SEGAINVEX-ELECTRONICA/Fuente-de-2KV-para-haz-de-electrones/readme.md

## [UNIVERSIDAD AUTÓNOMA DE MADRID](https://www.uam.es/UAM/Home.htm?language=es)
## [SEGAINVEX-Electrónica](https://www.uam.es/uam/segainvex)
**Proyecto OT:20161033**

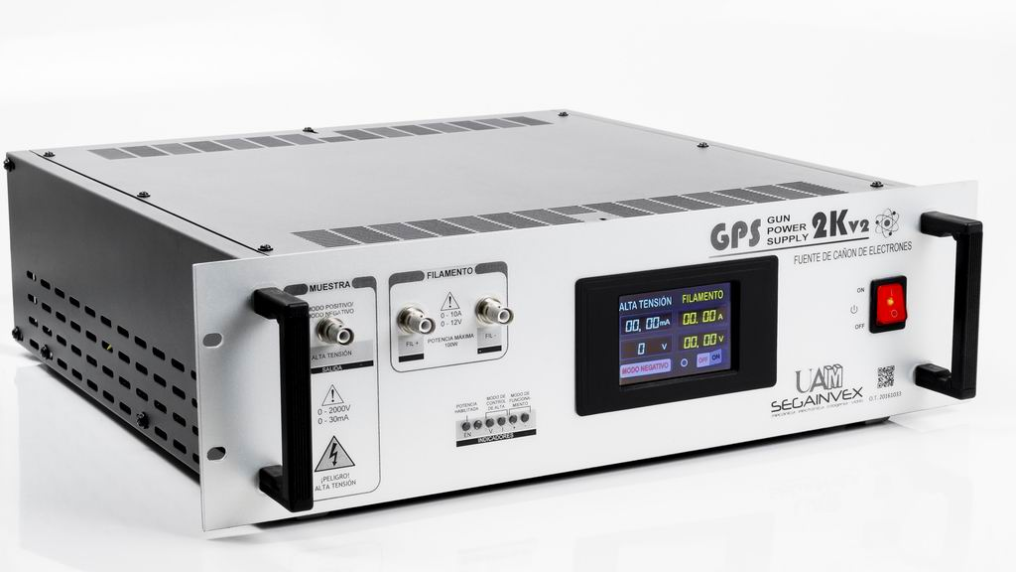
[picture p1: fotos/foto1.jpg]
frontal


## DESCRIPCIÓN
### Fuente de alimenación de +-2KV HV u 12V, 30mA en filamento para cañón de haz de electrones
### Controlable mediante pantalla táctil y/o software de PC por puerto USB o Bluetooth. La fuente se puede configura para dos modos de funcionamiento; haz de electrones o haz de iones. También se desarrolla el software de control para PC con LAbWindows/CVI.
 
### Desarrollado por SEGAINVEX-Electrónica para el [Departamento de Física de la Materia Condensada de la UAM](https://www.fmc.uam.es/research/nano-spm-lab/)
### Diciembre 2019

## [SOFTWARE DE PC](https://github.com/SEGAINVEX-ELECTRONICA/Fuente-de-2KV-para-haz-de-electrones/blob/main/software/)
### Desarrollado con [LabWindowsCVI de NI](https://www.ni.com/es-es.html)

## [FIRMWARE Arduino DUE](https://github.com/SEGAINVEX-ELECTRONICA/Fuente-de-2KV-para-haz-de-electrones/blob/main/firmware/)
### Desarrollado con [Atmel Studio 6](https://www.microchip.com/en-us/development-tools-tools-and-software/avr-and-sam-downloads-archive)
    
## [ESQUEMAS](https://github.com/SEGAINVEX-ELECTRONICA/Fuente-de-2KV-para-haz-de-electrones/blob/main/esquemas/)

## [PROYECTO HARDWARE](https://github.com/SEGAINVEX-ELECTRONICA/Fuente-de-2KV-para-haz-de-electrones/blob/main/proyecto/)
### 
## [FOTOS DEL EQUIPO](https://github.com/SEGAINVEX-ELECTRONICA/Fuente-de-2KV-para-haz-de-electrones/blob/main/fotos/) 
###
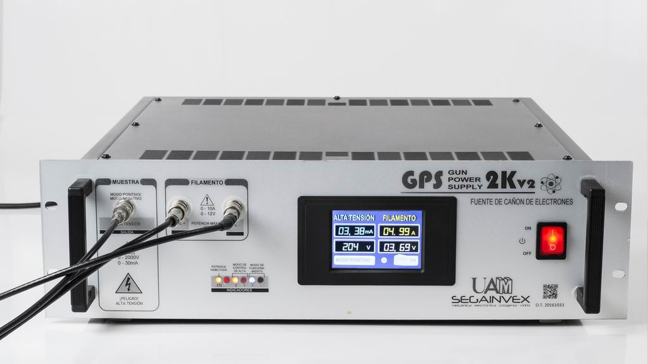
[picture p2: fotos/foto2.jpg]
Frontal

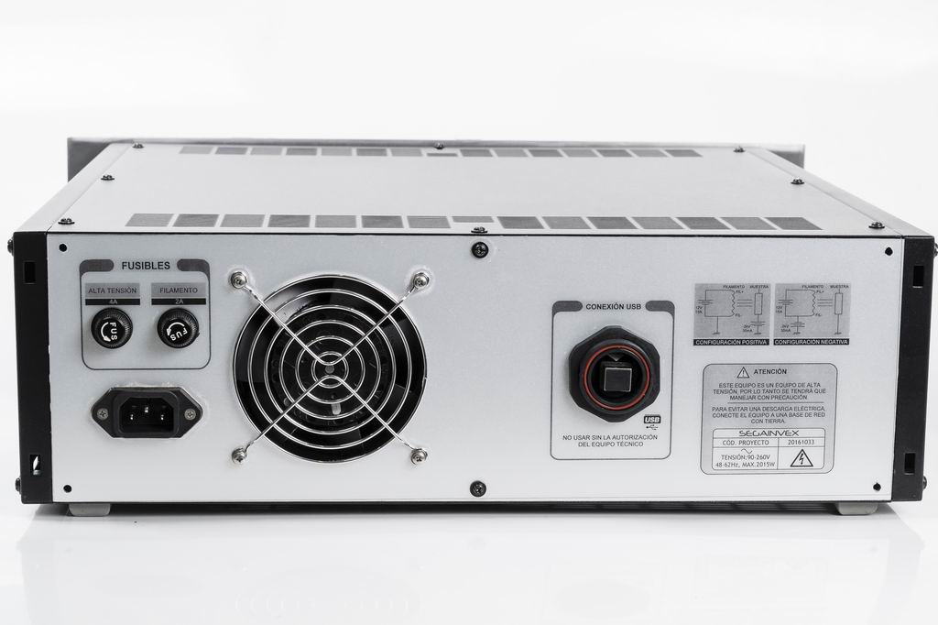
[picture p3: fotos/foto3.jpg]
Trasera

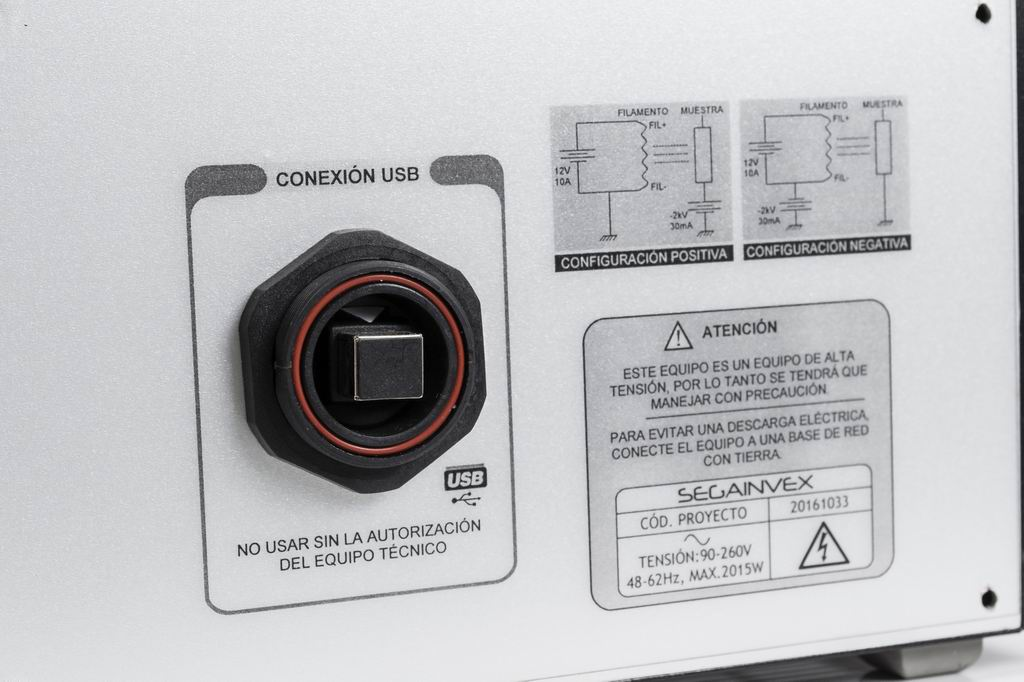
[picture p4: fotos/foto5.jpg]
Puerto USB

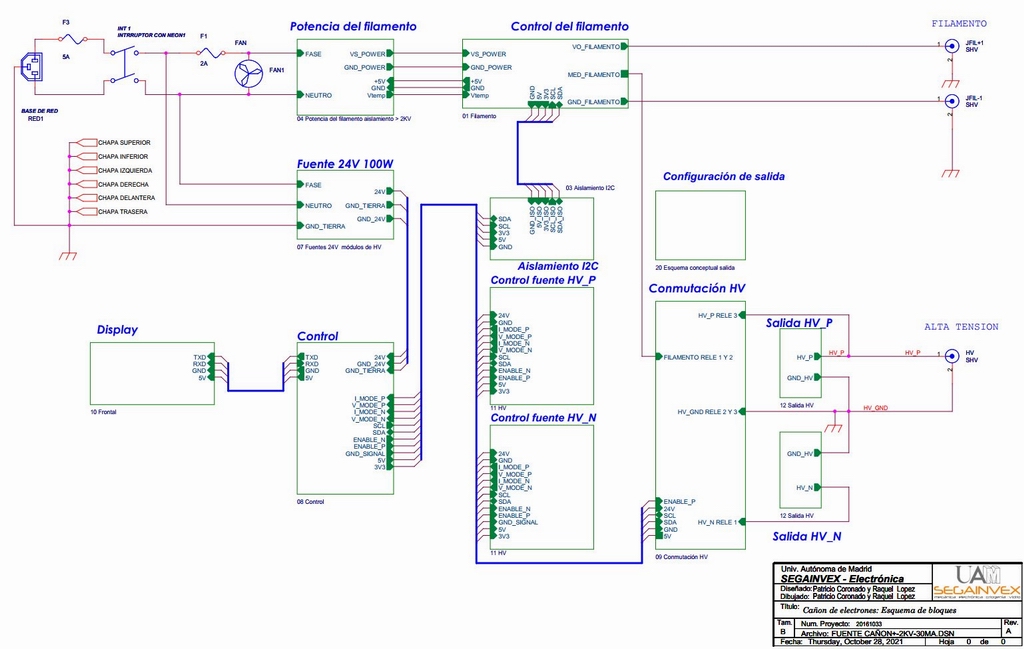
[picture p5: fotos/esquema.JPG]
Esquema de bloques

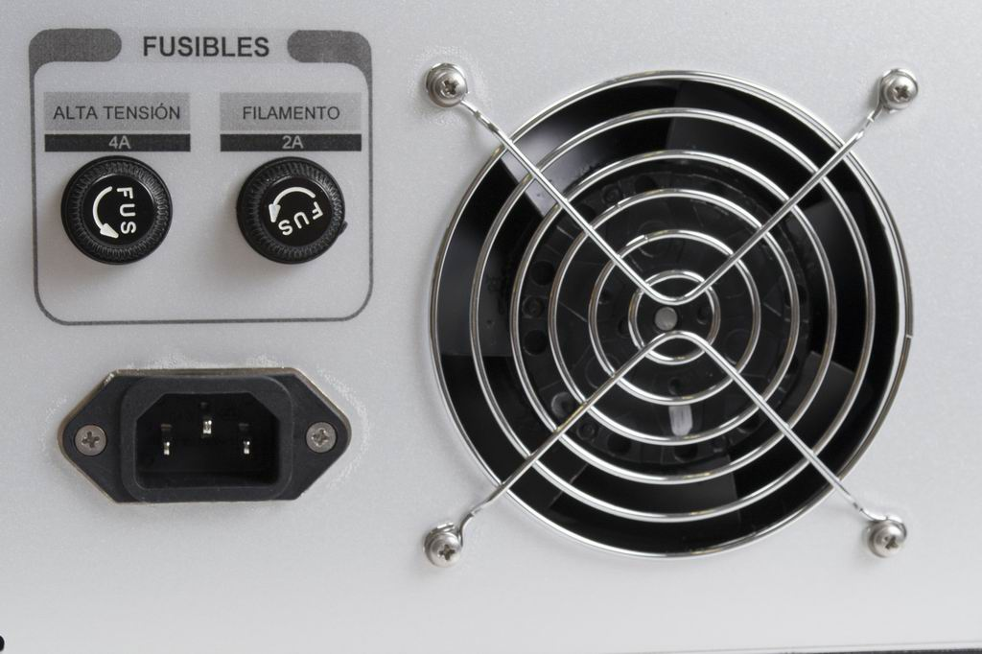
[picture p6: fotos/foto6.jpg]
Fusibles y ventilador

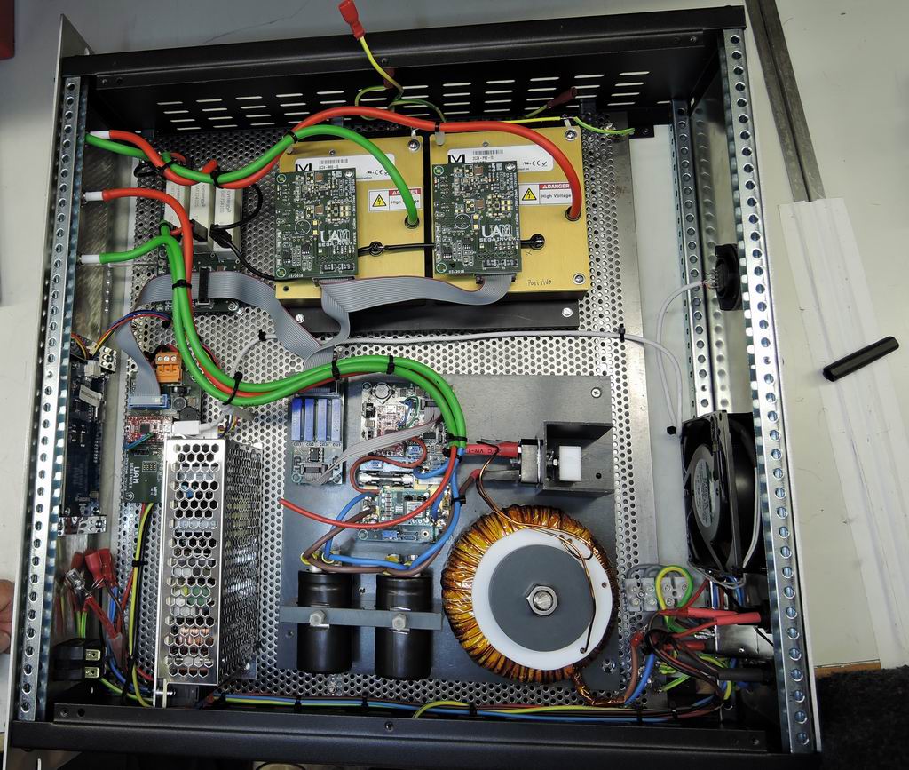
[picture p7: fotos/foto7.jpg]
Electrónica del sistema

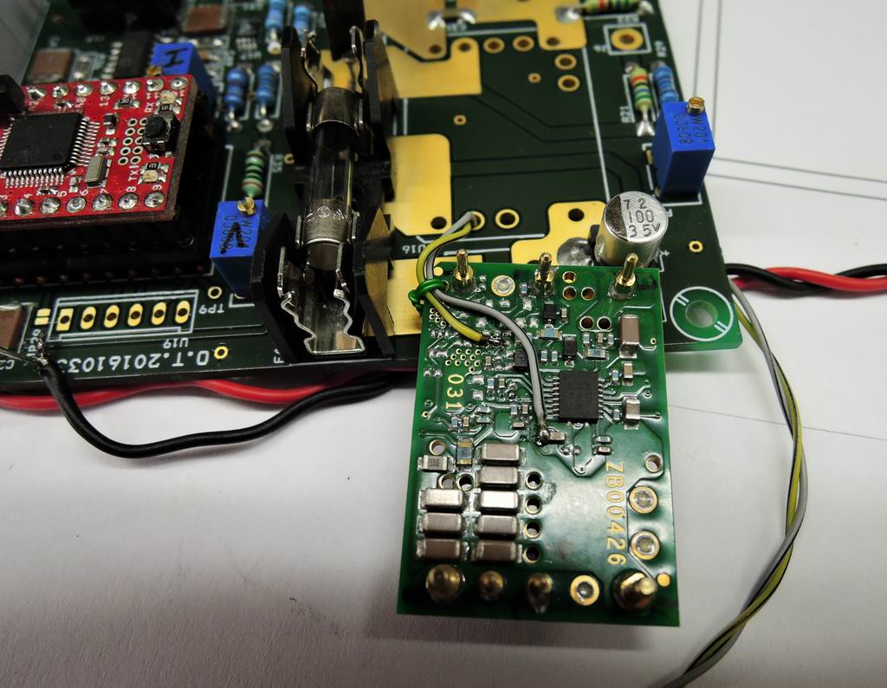
[picture p8: fotos/foto8.jpg]
Detalle del módulo de potencia del filamento

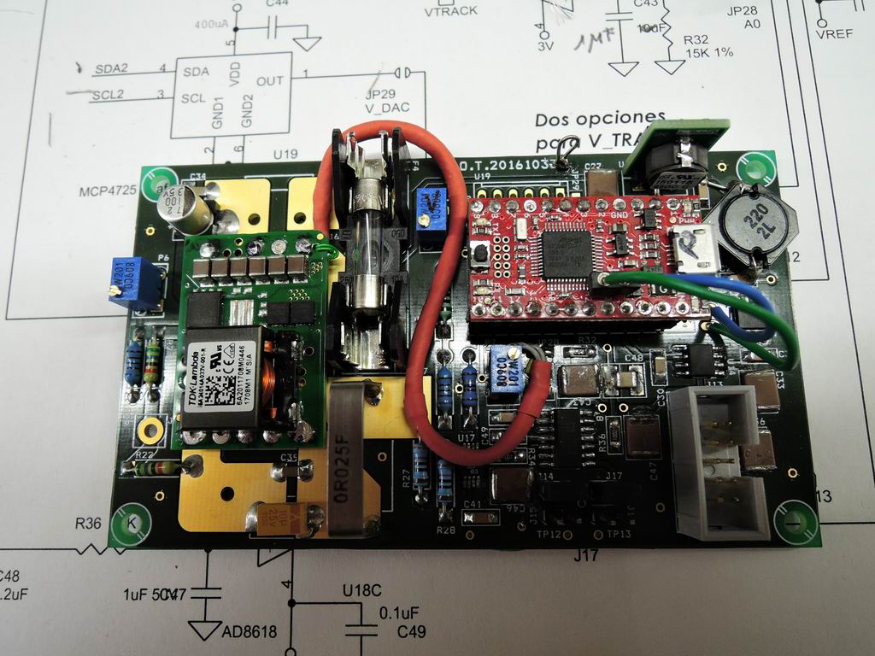
[picture p9: fotos/foto9.jpg]

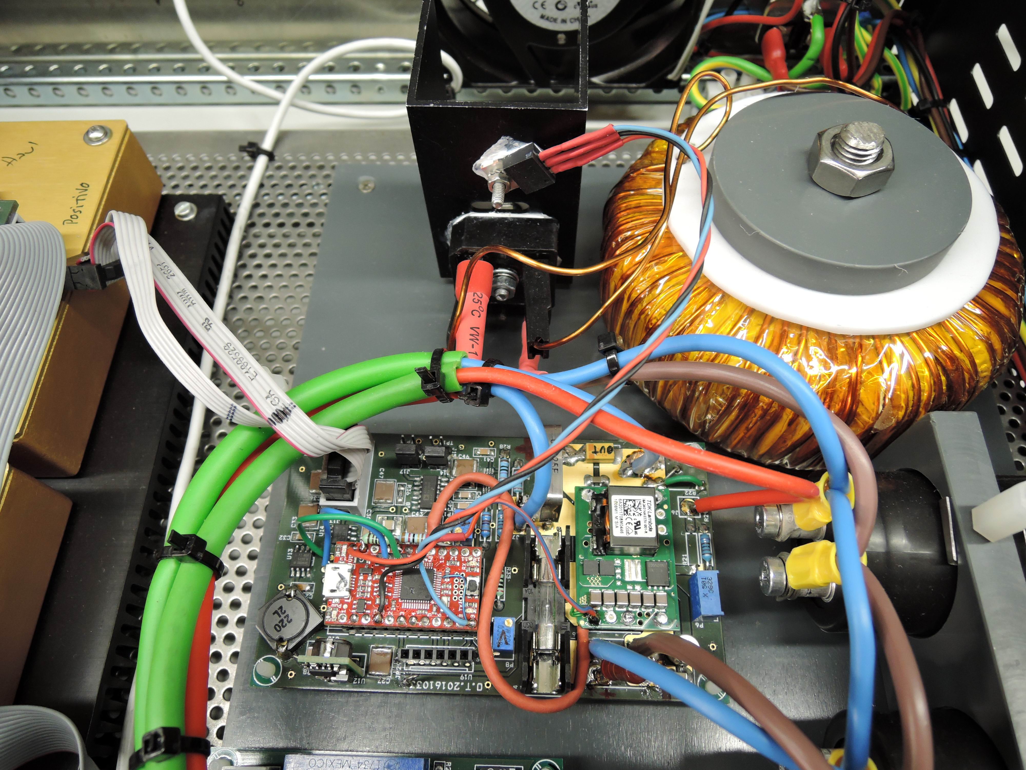
[picture p10: fotos/foto10.jpg]

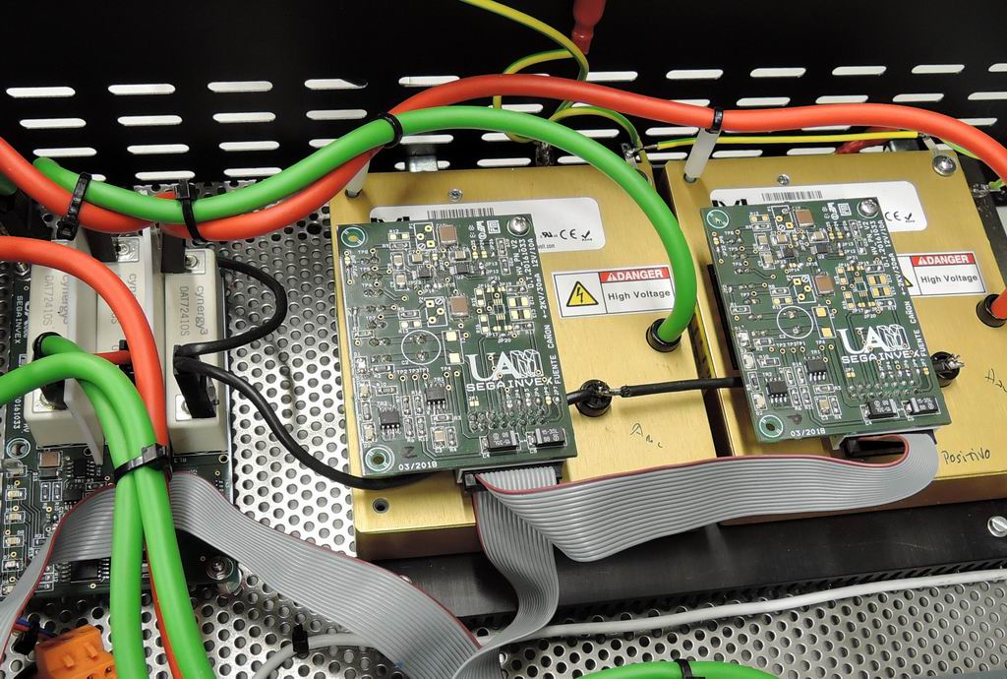
[picture p11: fotos/foto11.jpg]
Fuentes de HV y control

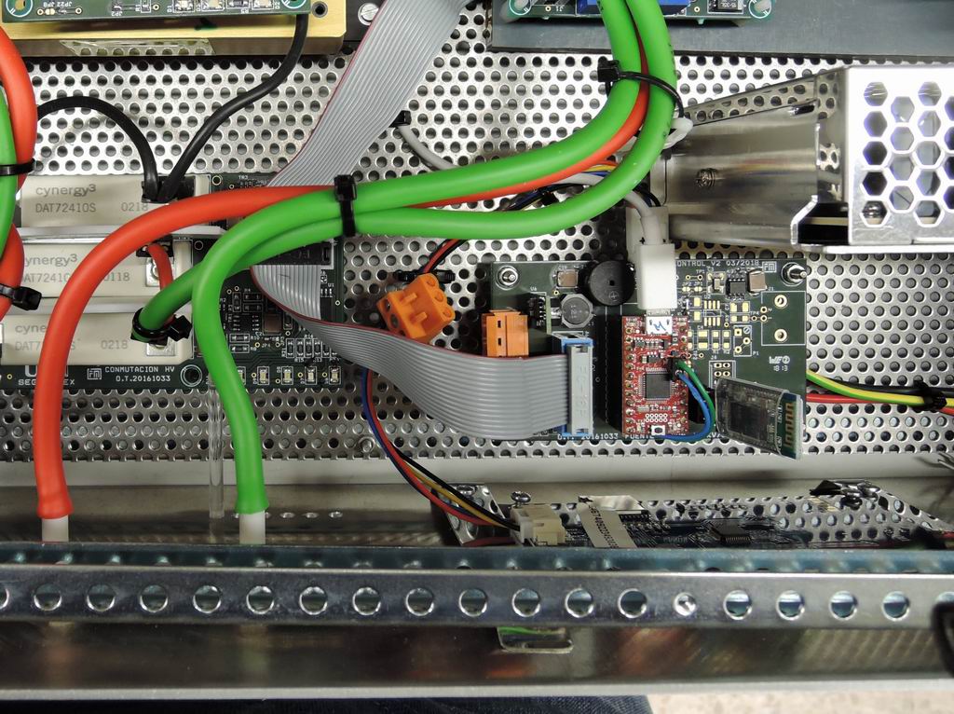
[picture p12: fotos/foto12.jpg]
Control de todo el sistema

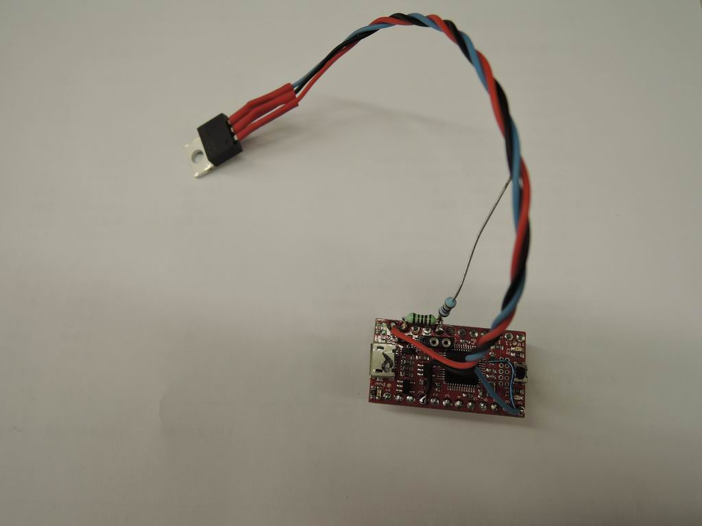
[picture p13: fotos/foto13.jpg]
microcontrolador del filamento y sensor de temperatura del puente rectificador


###### publicado desde "X:\Proyecto\2016\20161033 D Fuente cañon ±2KV-30mA, 12V-10A\[11] GITHUB"
