SEGAINVEX-ELECTRONICA/Fuente-de-2KV-para-haz-de-electrones/fotos/foto4.jpg

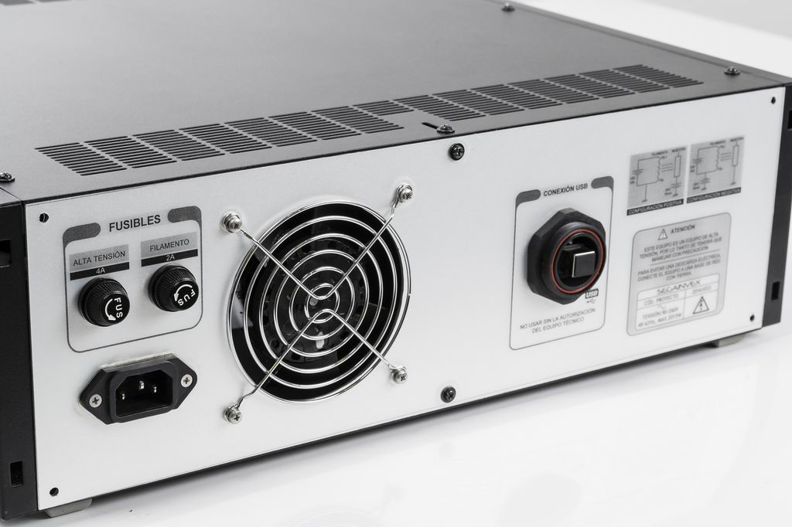
fotos/foto4.jpg
