SEGAINVEX-ELECTRONICA/Fuente-de-2KV-para-haz-de-electrones/esquemas/esquema_conceptual.pdf

# -FIL FPOL TIERRA

# -FIL FPOL TIERRA

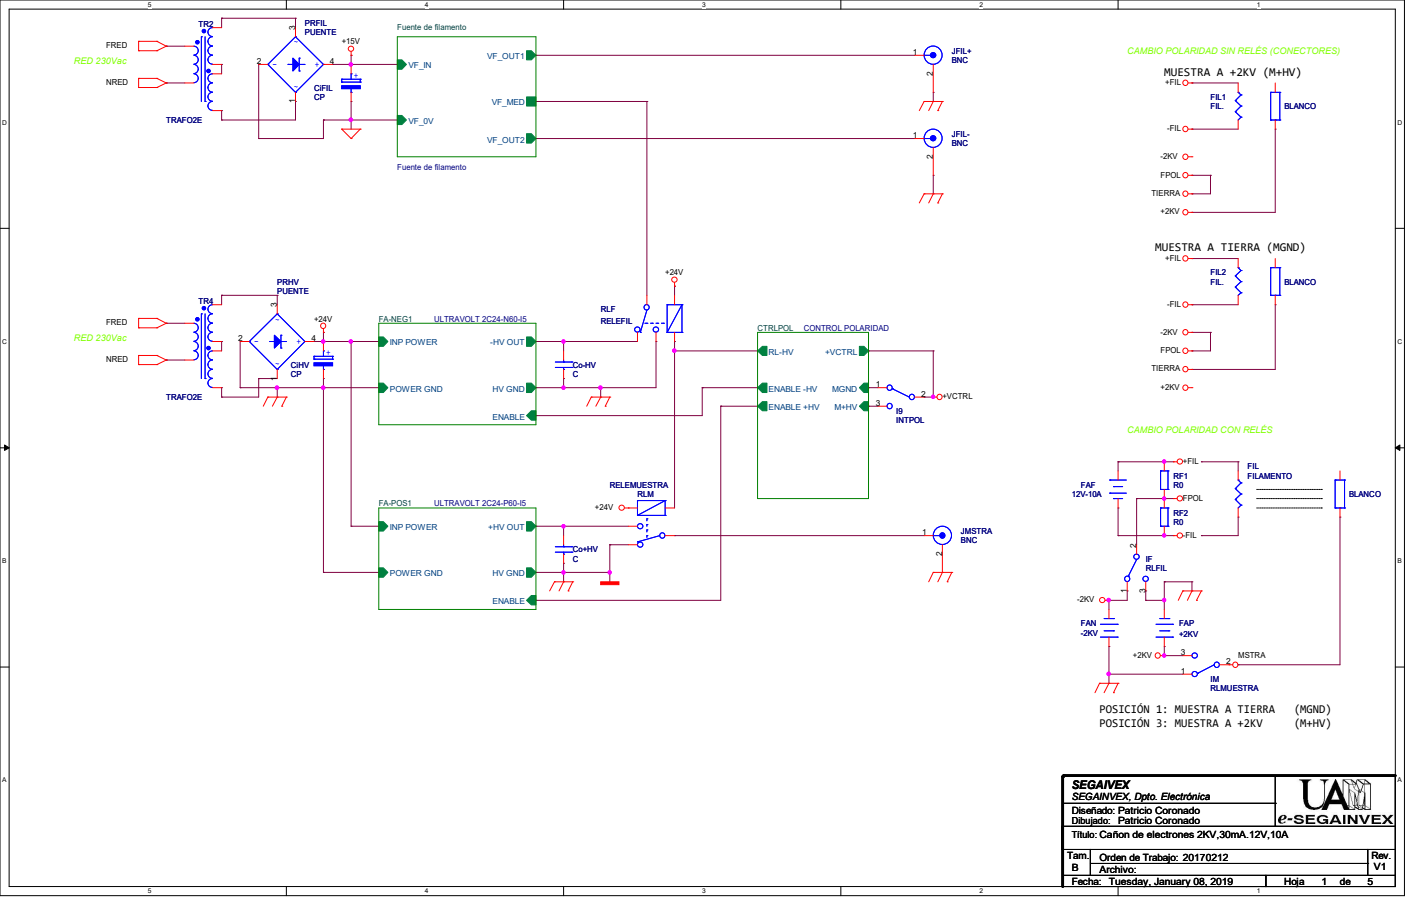
[picture p15: page 1]
FRED; NRED; +VCTRL; +FIL FPOL; MSTRA; -FIL Título:; Tam. Orden de Trabajo:; Rev.; Fecha:; Hoja; Diseñado: Dibujado:; SEGAINVEX, Dpto. Electrónica Archivo:; V1 Cañon de electrones 2KV,30mA.12V,10A; SEGAIVEX; Patricio Coronado B; Tuesday, January 08, 2019; 5 Patricio Coronado Título:; 5 Patricio Coronado; RED 230Vac; CAMBIO POLARIDAD CON RELÉS POSICIÓN 1: MUESTRA A TIERRA; (MGND); POSICIÓN 3: MUESTRA A +2KV; VF_OUT1 VF_OUT2 VF_MED; FIL1 FIL. FA-NEG1; ULTRAVOLT 2C24-N60-I5; -HV OUT POWER GND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

Fuente de filamento Fuente de filamento VF_IN

CAMBIO POLARIDAD SIN RELÉS (CONECTORES)
MUESTRA A +2KV (M+HV)
+FIL

2 CTRLPOL CONTROL POLARIDAD M+HV

MUESTRA A TIERRA (MGND)

FIL2 FIL. + CiHV CP
~PRHV
PUENTE
