SEGAINVEX-ELECTRONICA/Fuente-de-2KV-para-haz-de-electrones/esquemas/esquema_conceptual_filamento.pdf

# Salida al bus IC

# - Vsense(out) +

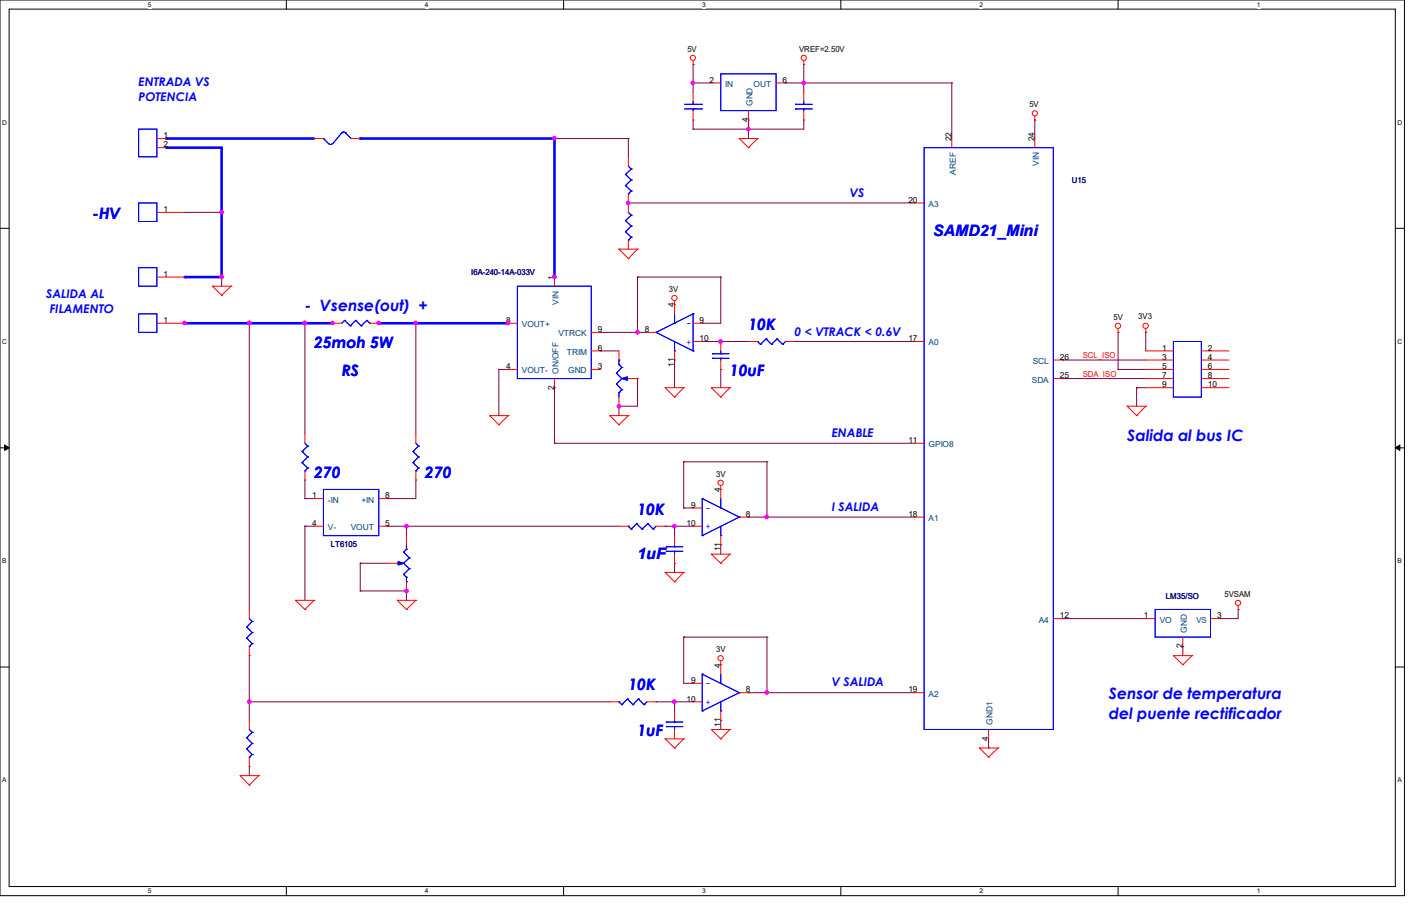
[picture p16: page 1]
SCL_ISO; SDA_ISO; VREF=2.50V; 5VSAM; SALIDA AL FILAMENTO; ENTRADA VS POTENCIA; I SALIDA; V SALIDA; 0 < VTRACK < 0.6V; ENABLE; GND; VIN; 1 ON/OFF; 4 OUT 6 U15 SAMD21_Mini GND¹; 4 GPIO8 11 A4 12; AREF 22; VIN ²⁴ SDA 25 SCL 26; VOUT; 25moh 5W

2 GND 3 VOUT- 4 TRIM 6 VOUT+ 8 VTRCK 9

Sensor de temperatura
del puente rectificador
