SEGAINVEX-ELECTRONICA/Fuente-de-2KV-para-haz-de-electrones/esquemas/0_esquema_de_bloques.pdf

## FILAMENTO

# Configuración de salida

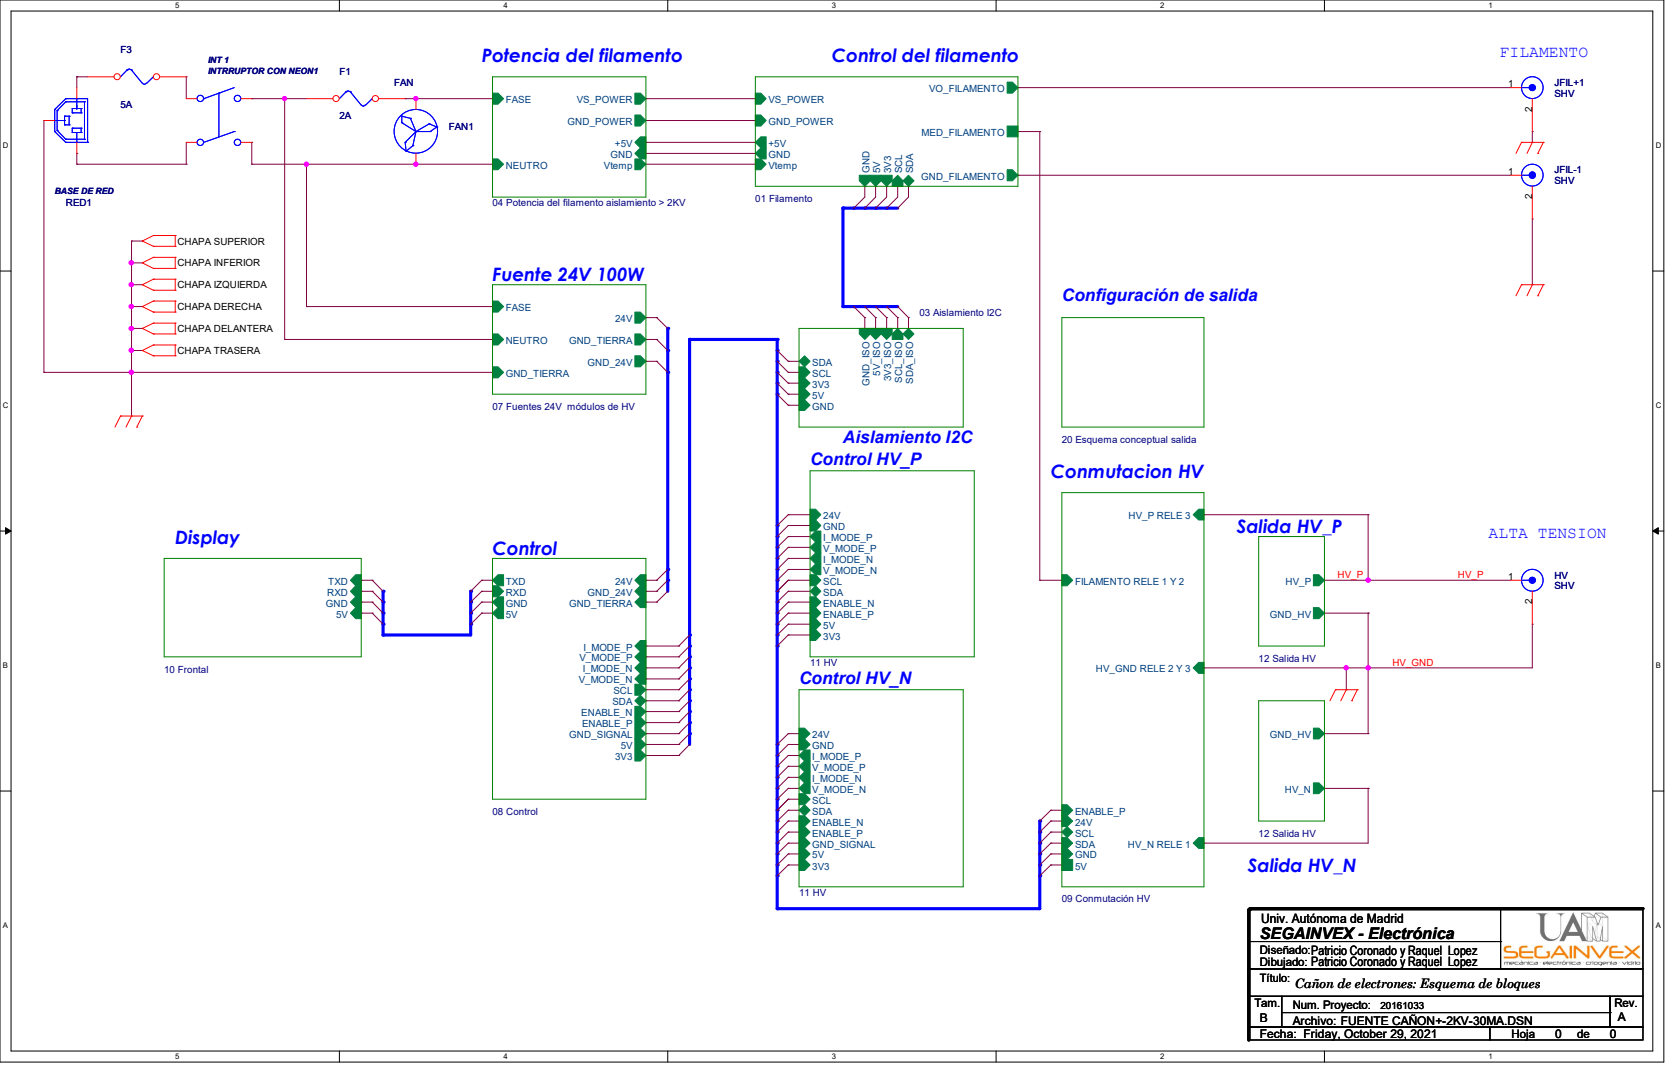
[picture p17: page 1]
HV_GND; CHAPA SUPERIOR; CHAPA INFERIOR; Título: Tam. Num. Proyecto:; Rev.; Fecha:; Hoja; de Diseñado: Dibujado: Archivo: SEGAINVEX - Electrónica; Friday, October 29, 2021; 0 FUENTE CAÑON+-2KV-30MA.DSN; 20161033 Título: Tam. Num. Proyecto:; ALTA TENSION; 24V GND_24V; FASE NEUTRO; GND_TIERRA; Control del filamento 01 Filamento; VO_FILAMENTO; GND_FILAMENTO; VS_POWER; GND_POWER; GND 5V3V³ SCL SDA; MED_FILAMENTO; +5V GND; Vtemp; INT 1; Display 10 Frontal; TXD; RXD GND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

F3 | INTRRUPTOR CON NEON1 F1

Potencia del filamento 04 Potencia del filamento aislamiento > 2KV

BASE DE RED
RED1

Fuente 24V 100W 07 Fuentes 24V módulos de HV

CHAPA IZQUIERDA CHAPA DERECHA CHAPA DELANTERA CHAPA TRASERA

20 Esquema conceptual salida
Conmutacion HV

Salida HV_P 12 Salida HV HV_P

Salida HV_N ¹² Salida HV HV_N

09 Conmutación HV HV_N RELE 1

Univ. Autónoma de Madrid
Patricio Coronado y Raquel Lopez B

Cañon de electrones: Esquema de bloques
