SEGAINVEX-ELECTRONICA/Fuente-de-2KV-para-haz-de-electrones/esquemas/conmutacion_hv.pdf

## TAMAÑO PLACA 120 X 70

P7 | P6

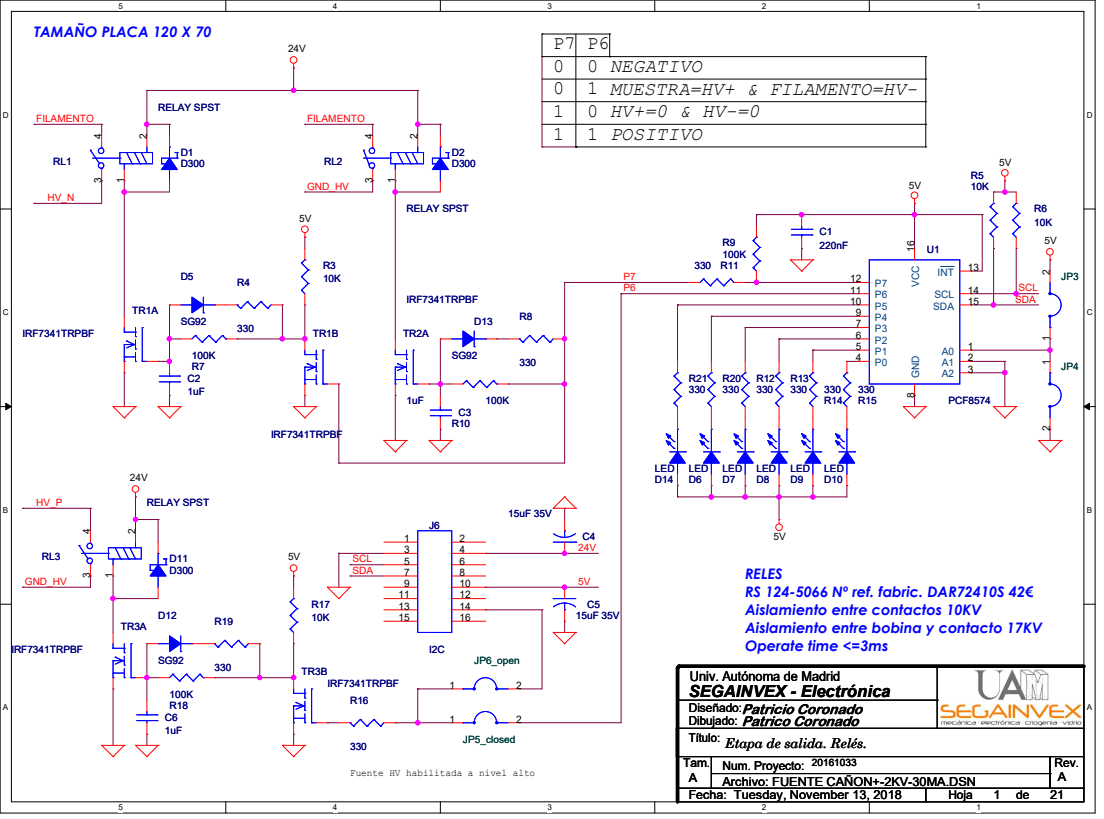
[picture p18: page 1]

0 | 0 NEGATIVO
0 | 1 MUESTRA=HV+ & FILAMENTO=HV-

RELES
RS 124-5066 Nº ref. fabric. DAR72410S 42€
Aislamiento entre contactos 10KV
Aislamiento entre bobina y contacto 17KV
Operate time <=3ms

Univ. Autónoma de Madrid
SEGAINVEX - Electrónica
Diseñado:
Dibujado:
Título:
Etapa de salida. Relés.

Fuente HV habilitada a nivel alto
