SEGAINVEX-ELECTRONICA/Fuente-de-2KV-para-haz-de-electrones/esquemas/control.pdf

## After power-up, the I/O pins are tri-stated

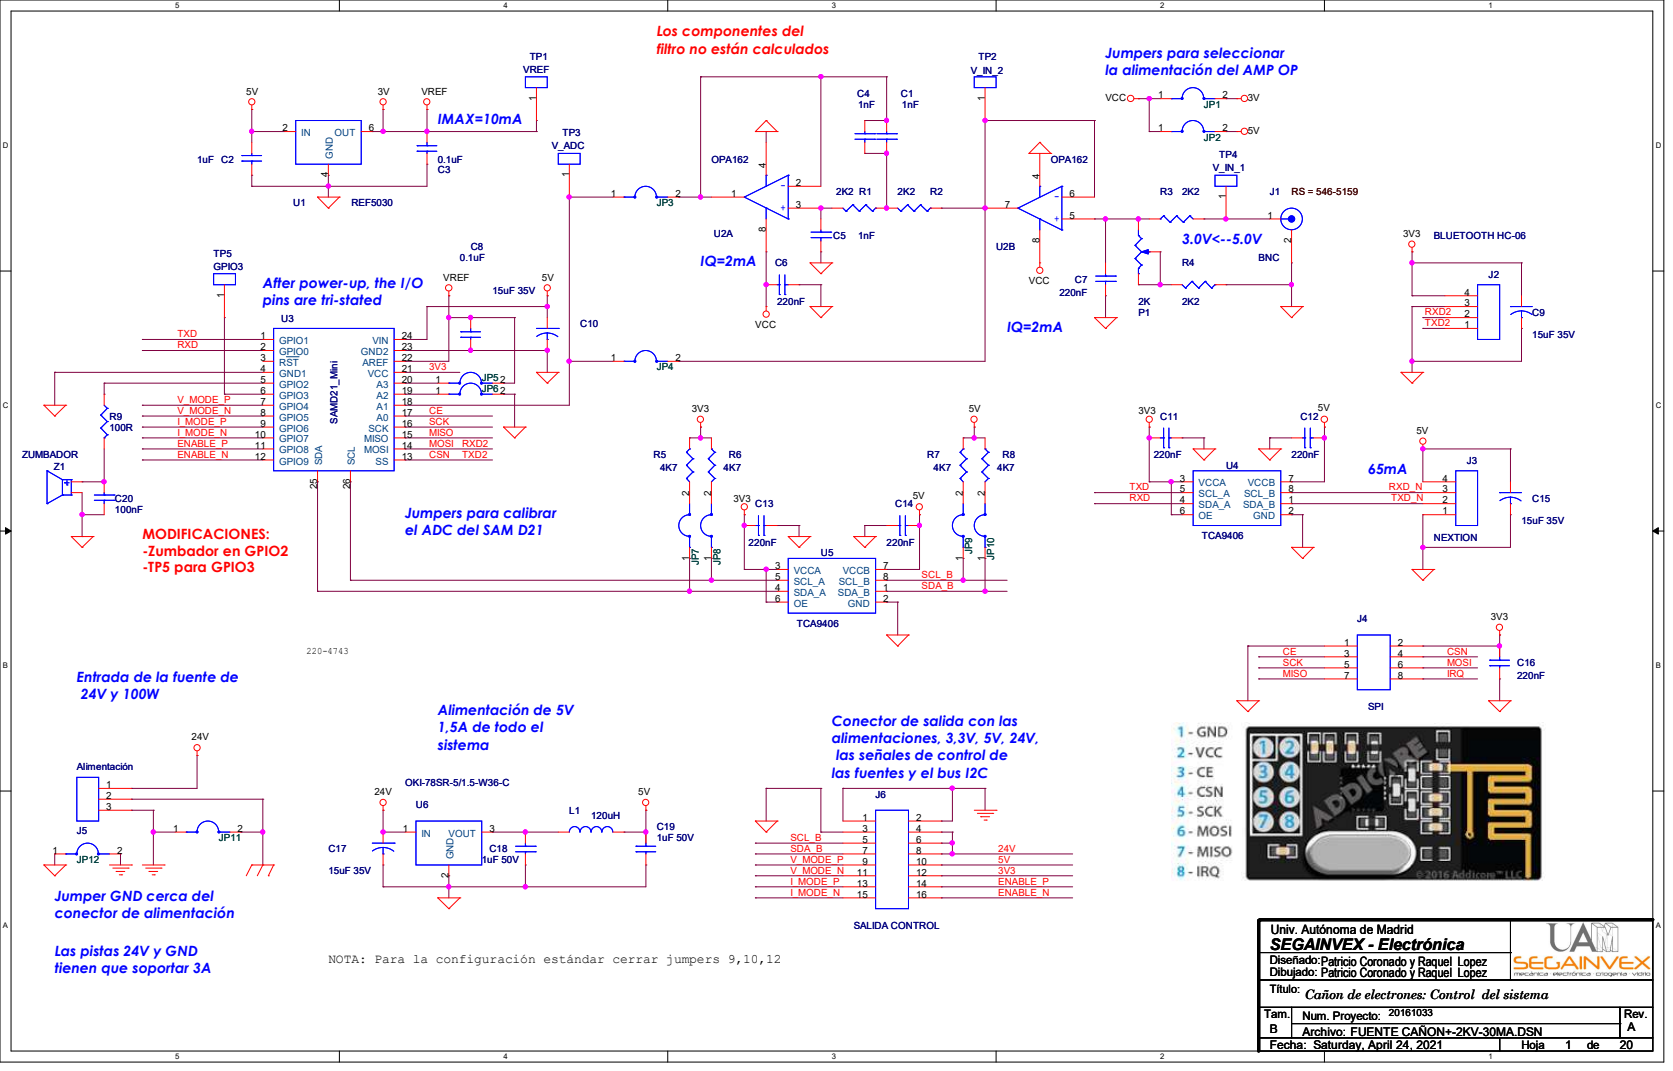
[picture p19: page 1]

Los componentes del
filtro no están calculados

Jumpers para seleccionar
la alimentación del AMP OP

1 U3 SAMD21_Mini GPIO1 1 GPIO0 2 RST 3 GND1 4 GPIO6 9 GPIO7 10 GPIO8 11 GPIO9 12 SS 13 MOSI 14 MISO 15 SCK 16 A0 17 A1 18 A2 19 A3 20 VCC 21 AREF 22 GND2 23 VIN 24 GPIO2 5 GPIO3 6 GPIO4 7 GPIO5 8 SDA 25 SCL 26

Jumpers para calibrar
el ADC del SAM D21

Entrada de la fuente de

Conector de salida con las
alimentaciones, 3,3V, 5V, 24V,
las señales de control de
las fuentes y el bus I2C

Jumper GND cerca del
conector de alimentación

Univ. Autónoma de Madrid
Patricio Coronado y Raquel Lopez B

NOTA: Para la configuración estándar cerrar jumpers 9,10,12

Cañon de electrones: Control del sistema
