SEGAINVEX-ELECTRONICA/Fuente-de-2KV-para-haz-de-electrones/esquemas/control_del_filamento.pdf

| U12 OKI-78SR-5/1.5-W36-C ENTRADA VS=18V a 24V J12

# ON/OFF VTRACK

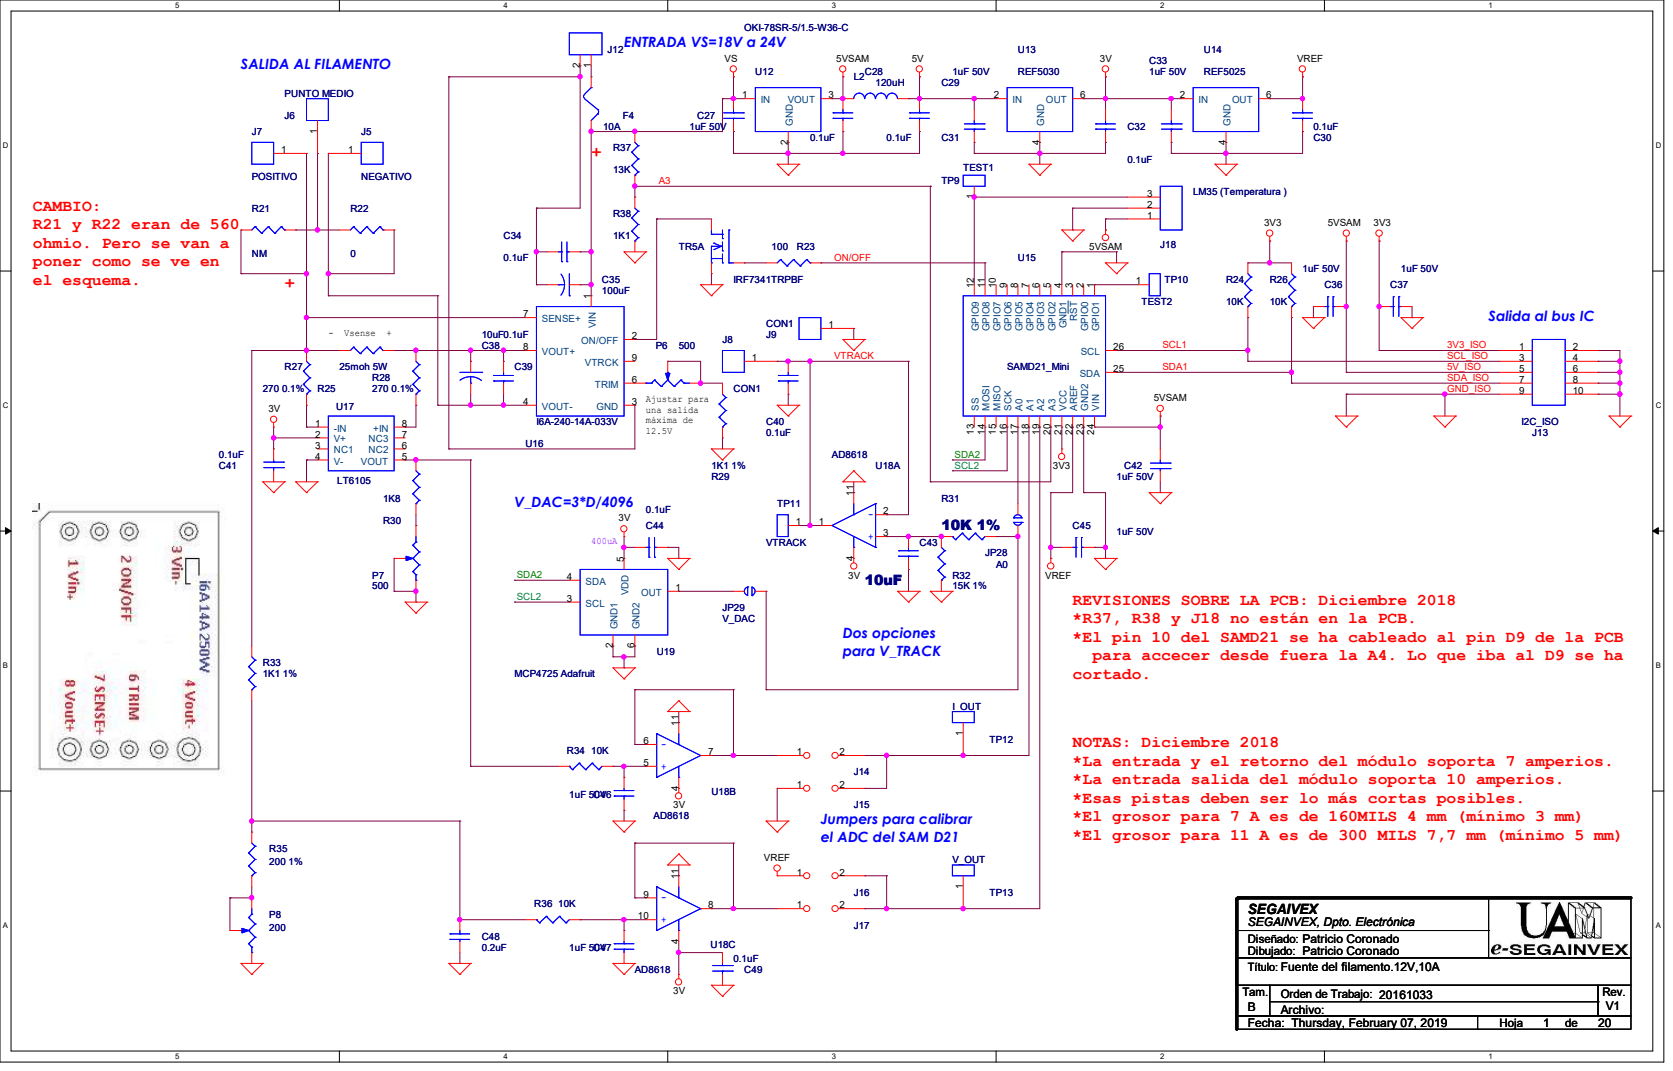
[picture p20: page 1]

CAMBIO:
R21 y R22 eran de 560
ohmio. Pero se van a
poner como se ve en
el esquema.

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

1 ON/OFF 2 GND 3 VOUT- 4 TRIM 6 SENSE+ 7 VOUT+ 8 VTRCK 9
I6A-240-14A-033V VIN

Salida al bus IC

VREF
REVISIONES SOBRE LA PCB: Diciembre 2018
*R37, R38 y J18 no están en la PCB.
*El pin 10 del SAMD21 se ha cableado al pin D9 de la PCB
para accecer desde fuera la A4. Lo que iba al D9 se ha
cortado.

NOTAS: Diciembre 2018
*La entrada y el retorno del módulo soporta 7 amperios.
*La entrada salida del módulo soporta 10 amperios.
*Esas pistas deben ser lo más cortas posibles.
*El grosor para 7 A es de 160MILS 4 mm (mínimo 3 mm)
*El grosor para 11 A es de 300 MILS 7,7 mm (mínimo 5 mm)

Jumpers para calibrar
el ADC del SAM D21
