SEGAINVEX-ELECTRONICA/Fuente-de-2KV-para-haz-de-electrones/esquemas/control_fuente_hv_n.pdf

## Todos los conectores en la capa botton y a 90º, menos el de la fuente HV. Los Componentes altos en la capa botton

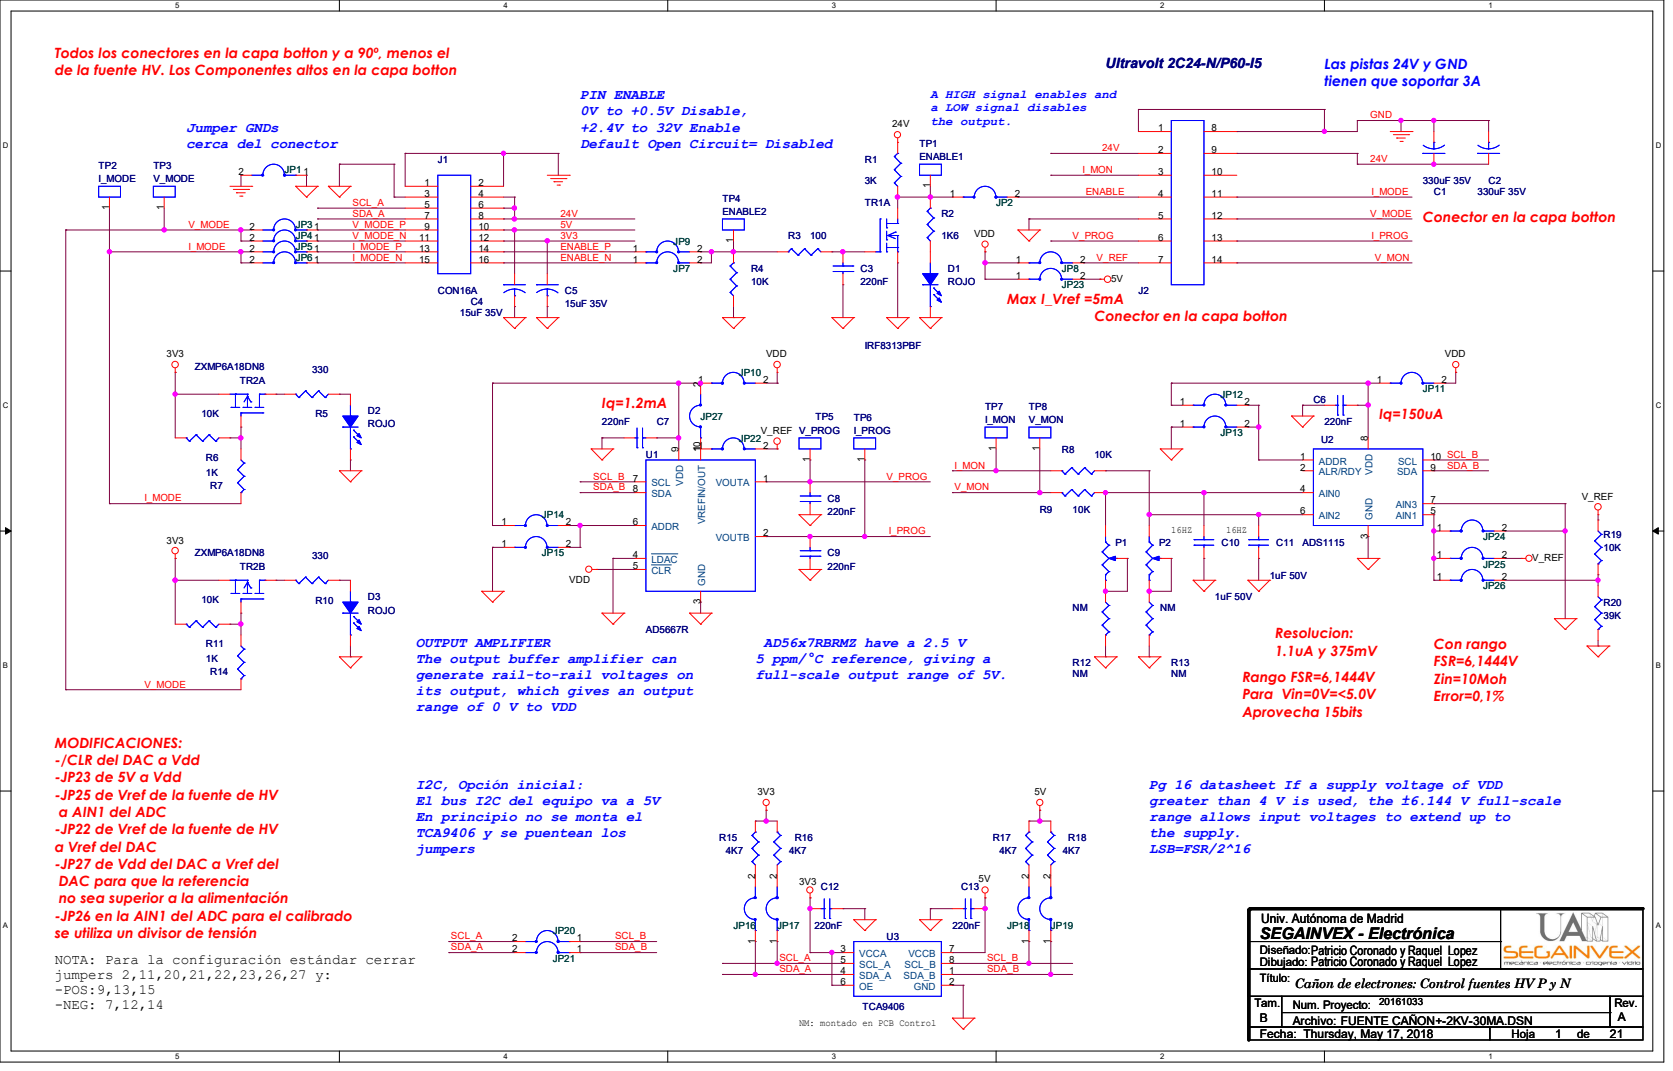
[picture p21: page 1]

PIN ENABLE
0V to +0.5V Disable,
+2.4V to 32V Enable
Default Open Circuit= Disabled

A HIGH signal enables and
a LOW signal disables
the output.

OUTPUT AMPLIFIER
The output buffer amplifier can
generate rail-to-rail voltages on
its output, which gives an output
range of 0 V to VDD

AD56x7RBRMZ have a 2.5 V
5 ppm/°C reference, giving a
full-scale output range of 5V.

MODIFICACIONES:
-/CLR del DAC a Vdd
-JP23 de 5V a Vdd
-JP25 de Vref de la fuente de HV
a AIN1 del ADC
-JP22 de Vref de la fuente de HV
a Vref del DAC
-JP27 de Vdd del DAC a Vref del
DAC para que la referencia
no sea superior a la alimentación
-JP26 en la AIN1 del ADC para el calibrado
NOTA: Para la configuración estándar cerrar
jumpers 2,11,20,21,22,23,26,27 y:

I2C, Opción inicial:
El bus I2C del equipo va a 5V
En principio no se monta el
TCA9406 y se puentean los
jumpers

Pg 16 datasheet If a supply voltage of VDD
greater than 4 V is used, the ±6.144 V full-scale
range allows input voltages to extend up to
the supply.
LSB=FSR/2^16

Univ. Autónoma de Madrid
Patricio Coronado y Raquel Lopez B

Cañon de electrones: Control fuentes HV P y N
