SEGAINVEX-ELECTRONICA/Fuente-de-2KV-para-haz-de-electrones/esquemas/display.pdf

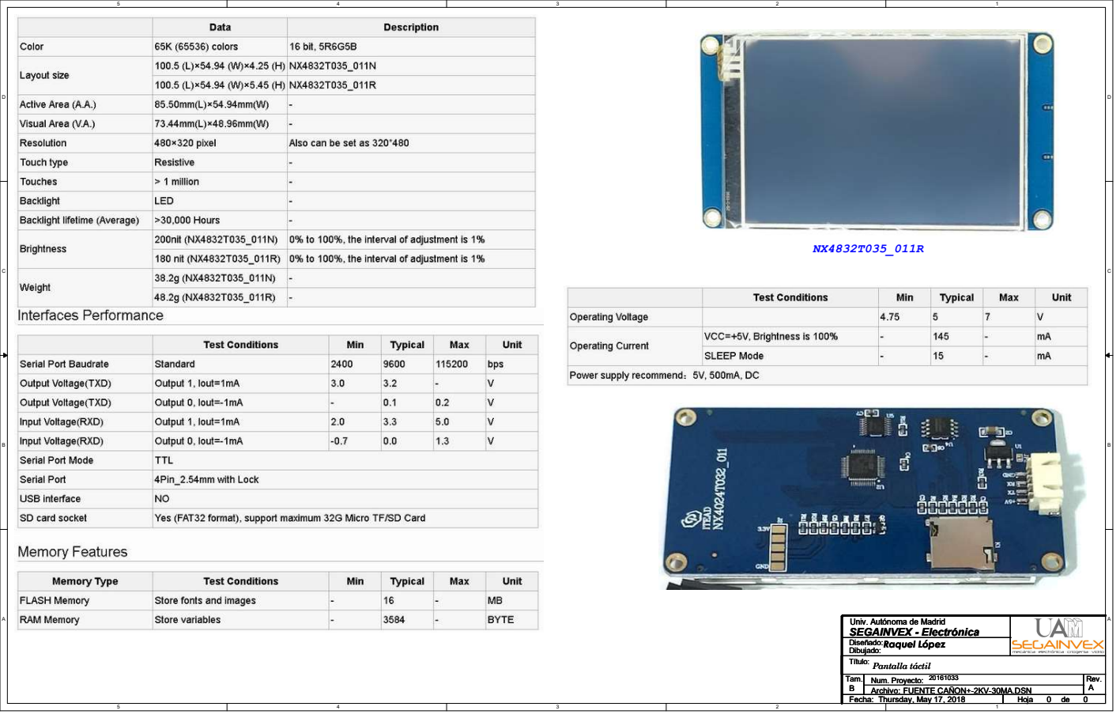
[picture p22: page 1]
A Título: Tam. Num. Proyecto:; Rev.; Fecha:; Hoja; de Diseñado: Dibujado: Archivo: SEGAINVEX - Electrónica; Pantalla táctil; Thursday, May 17, 2018; 0 FUENTE CAÑON+-2KV-30MA.DSN; 20161033 Título: Tam. Num. Proyecto:

Univ. Autónoma de Madrid
Raquel López B
