SEGAINVEX-ELECTRONICA/Fuente-de-2KV-para-haz-de-electrones/esquemas/fuente_24v_100w.pdf

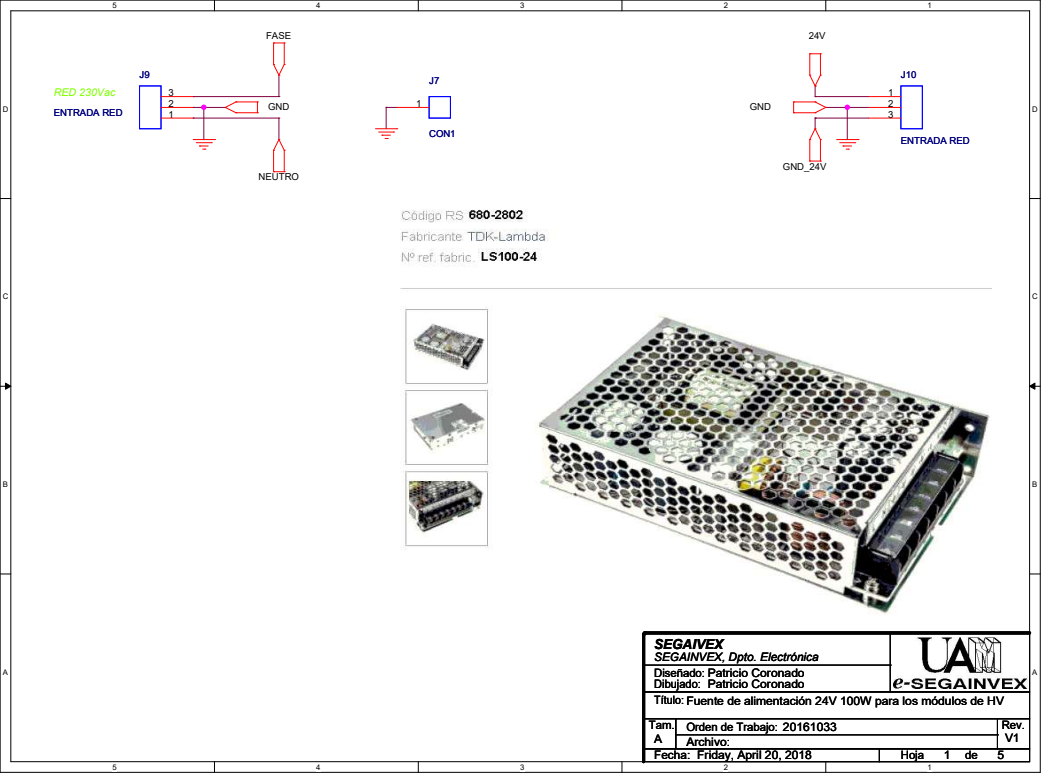
[picture p23: page 1]
GND_24V; FASE; NEUTRO; GND; Tam. Orden de Trabajo:; Rev.; Fecha:; Hoja; Patricio Coronado; Friday, April 20, 2018; RED 230Vac; ENTRADA RED; CON1

SEGAIVEX
SEGAINVEX, Dpto. Electrónica
Diseñado:
Dibujado:
Título:
Fuente de alimentación 24V 100W para los módulos de HV
Archivo:
