SEGAINVEX-ELECTRONICA/Fuente-de-2KV-para-haz-de-electrones/esquemas/potencia_del_filamento.pdf

# FASE NEUTRO

## Transformador 220Vac 160VA con aislamiento entre primario y secundario

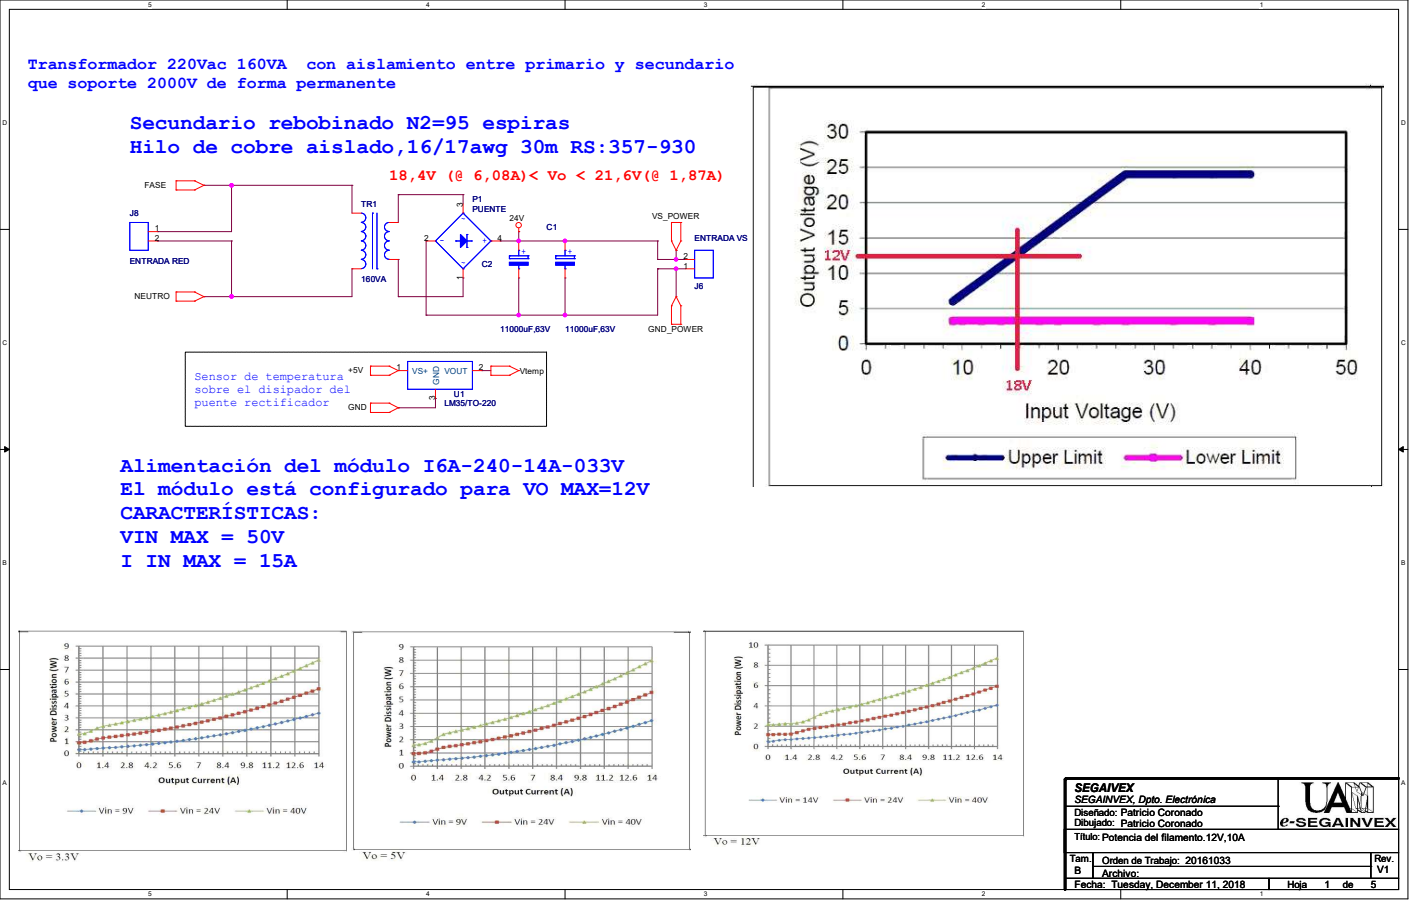
[picture p24: page 1]
VS_POWER; GND_POWER; +5V GND; Vtemp; Título: Tam. Orden de Trabajo:; Rev.; Fecha:; Hoja; de Diseñado: Dibujado:; SEGAINVEX, Dpto. Electrónica Archivo:; V1 Potencia del filamento.12V,10A; SEGAIVEX; Patricio Coronado B; Tuesday, December 11, 2018; 5 Patricio Coronado Título: Tam. Orden de Trabajo:; 5 Patricio Coronado; puente rectificador; VOUT; 2 GND; J6ENTRADA VS; J8ENTRADA RED; ~ P1PUENTE; ~ P1PUENTE ³

que soporte 2000V de forma permanente

Secundario rebobinado N2=95 espiras
Hilo de cobre aislado,16/17awg 30m RS:357-930

Sensor de temperatura
sobre el disipador del

Alimentación del módulo I6A-240-14A-033V
El módulo está configurado para VO MAX=12V
CARACTERÍSTICAS:
VIN MAX = 50V
I IN MAX = 15A
