SEGAINVEX-ELECTRONICA/Fuente-de-2KV-para-haz-de-electrones/esquemas/esquema_conceptual_salida.pdf

- +

## POSICIÓN 1:

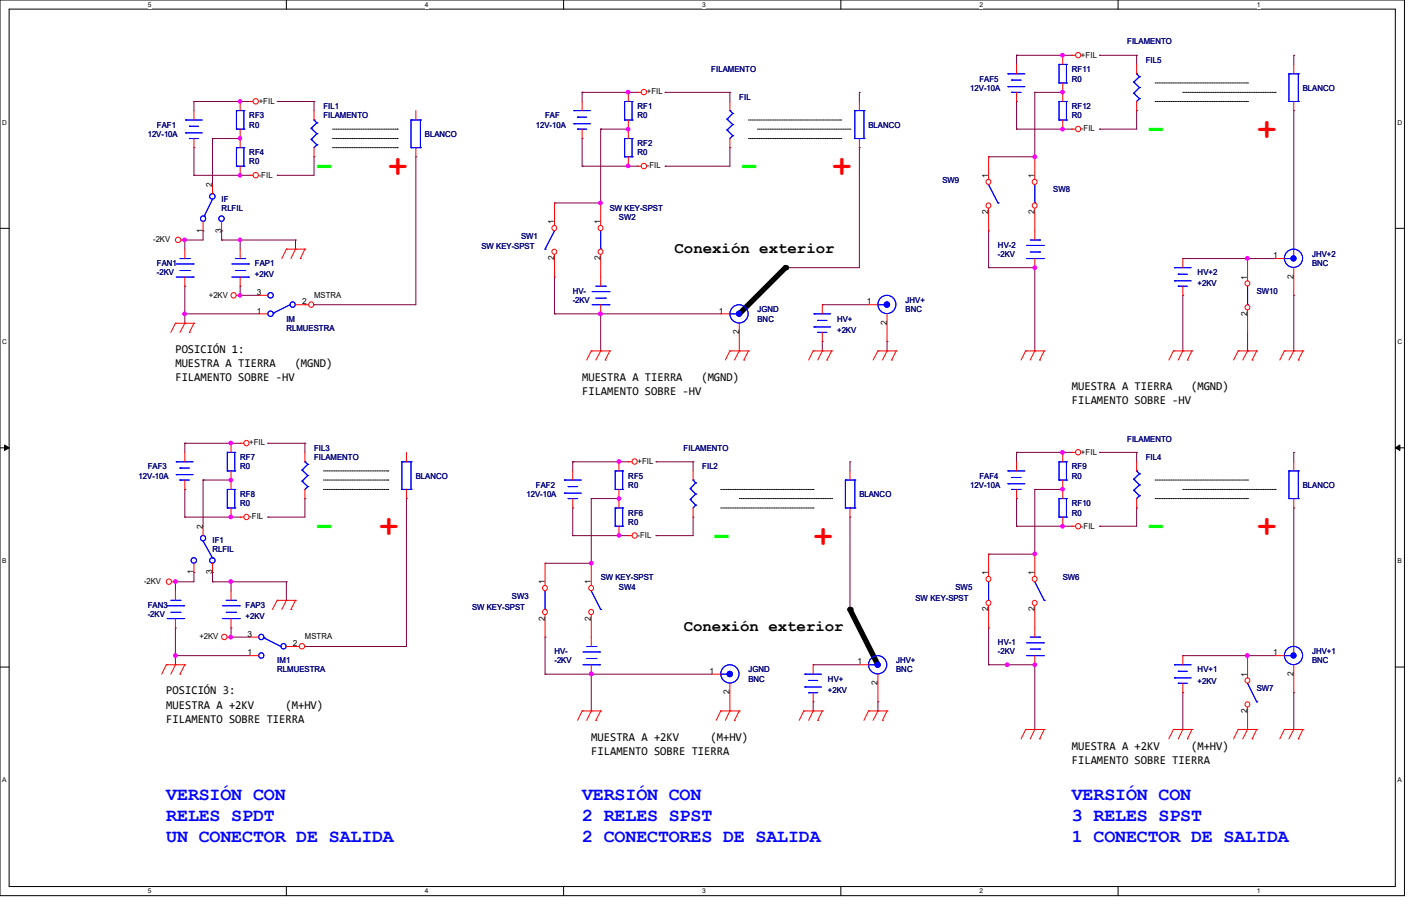
[picture p25: page 1]

VERSIÓN CON
RELES SPDT
UN CONECTOR DE SALIDA
