SEGAINVEX-ELECTRONICA/Fuente-de-2KV-para-haz-de-electrones/esquemas/aislamiento_i2c.pdf

## Aislamiento galvanico 2KV

2K2 R27

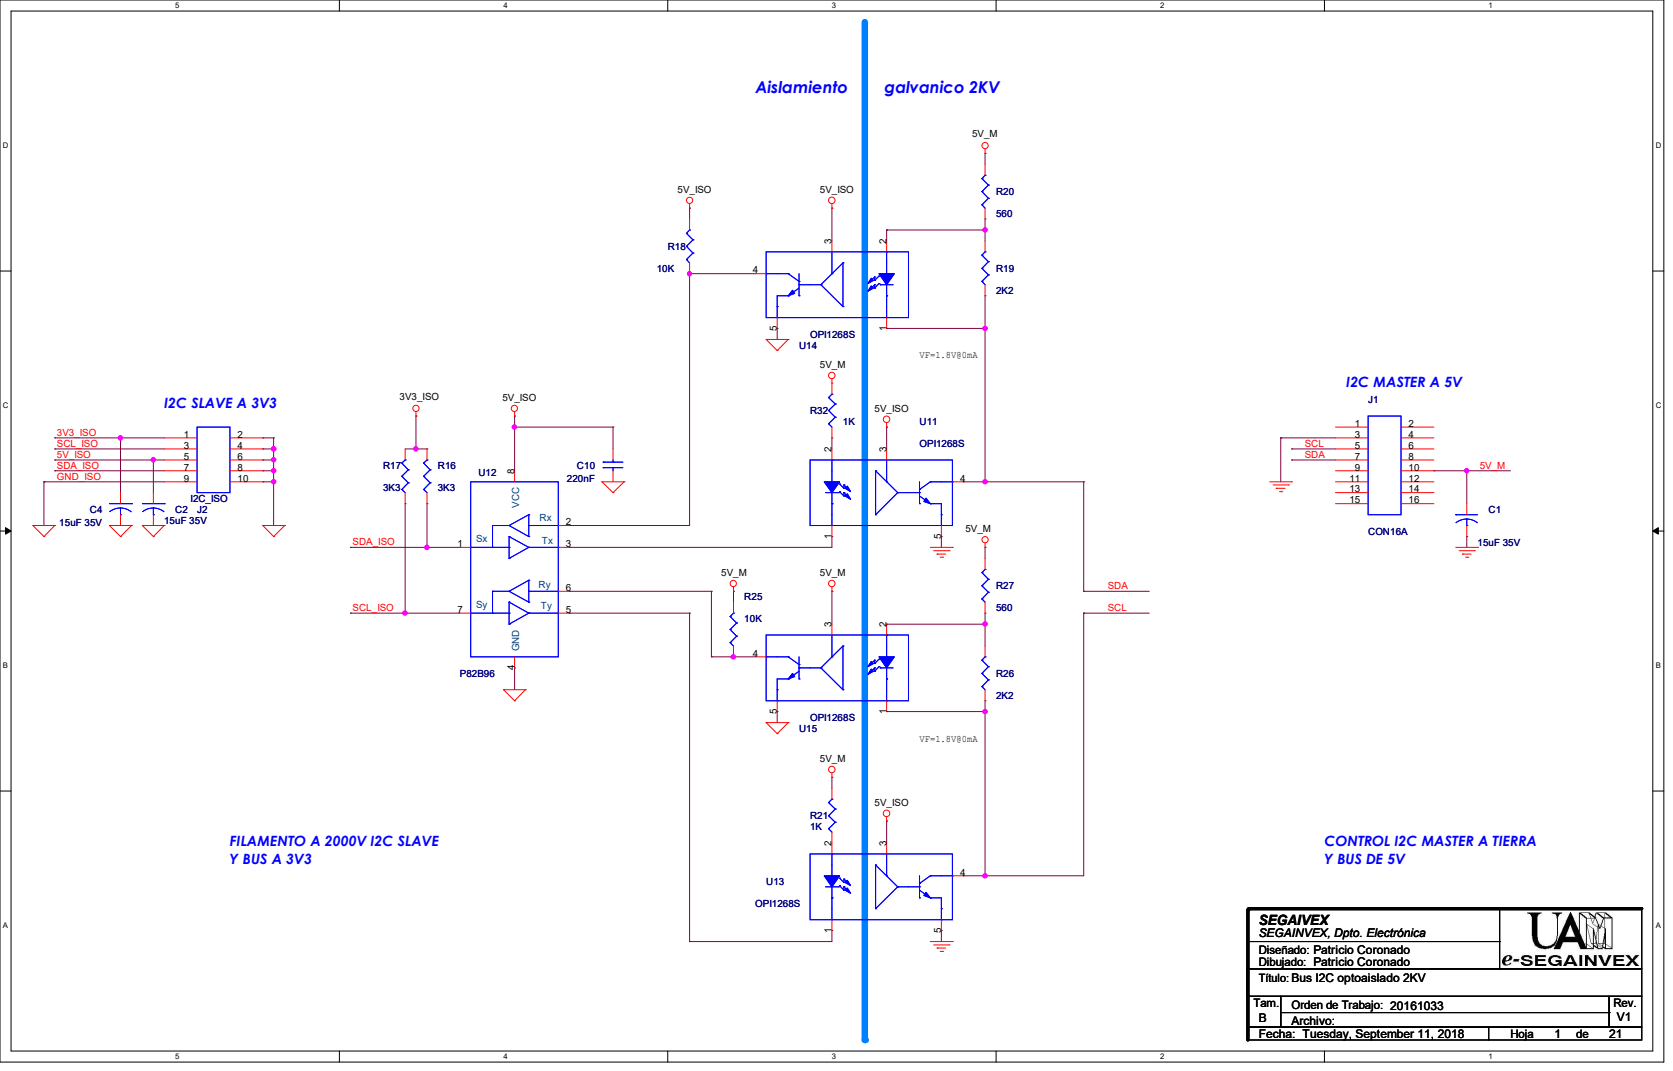
[picture p26: page 1]
