SEGAINVEX-ELECTRONICA/Fuente-de-2KV-para-haz-de-electrones/esquemas/configuracion_de_salida.pdf

- +

# Conexión exterior

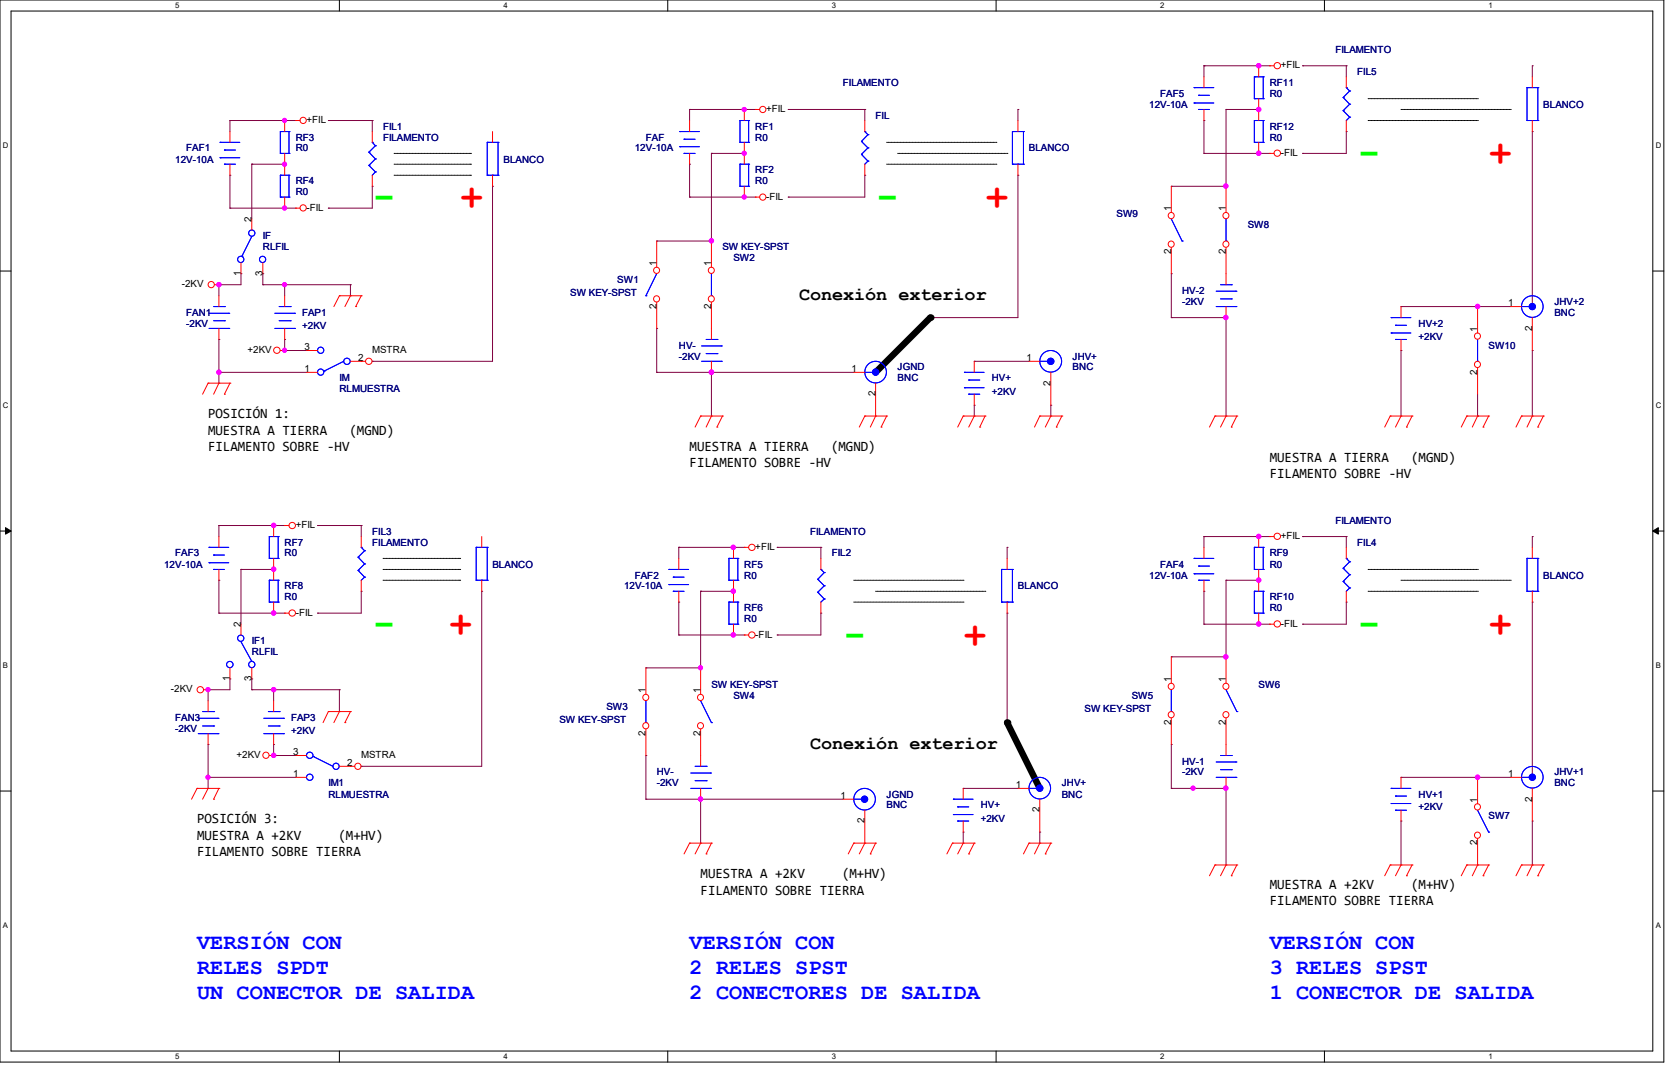
[picture p27: page 1]

VERSIÓN CON
RELES SPDT
UN CONECTOR DE SALIDA
