SEGAINVEX-ELECTRONICA/Fuente-de-2KV-para-haz-de-electrones/esquemas/salida_hv_n.pdf

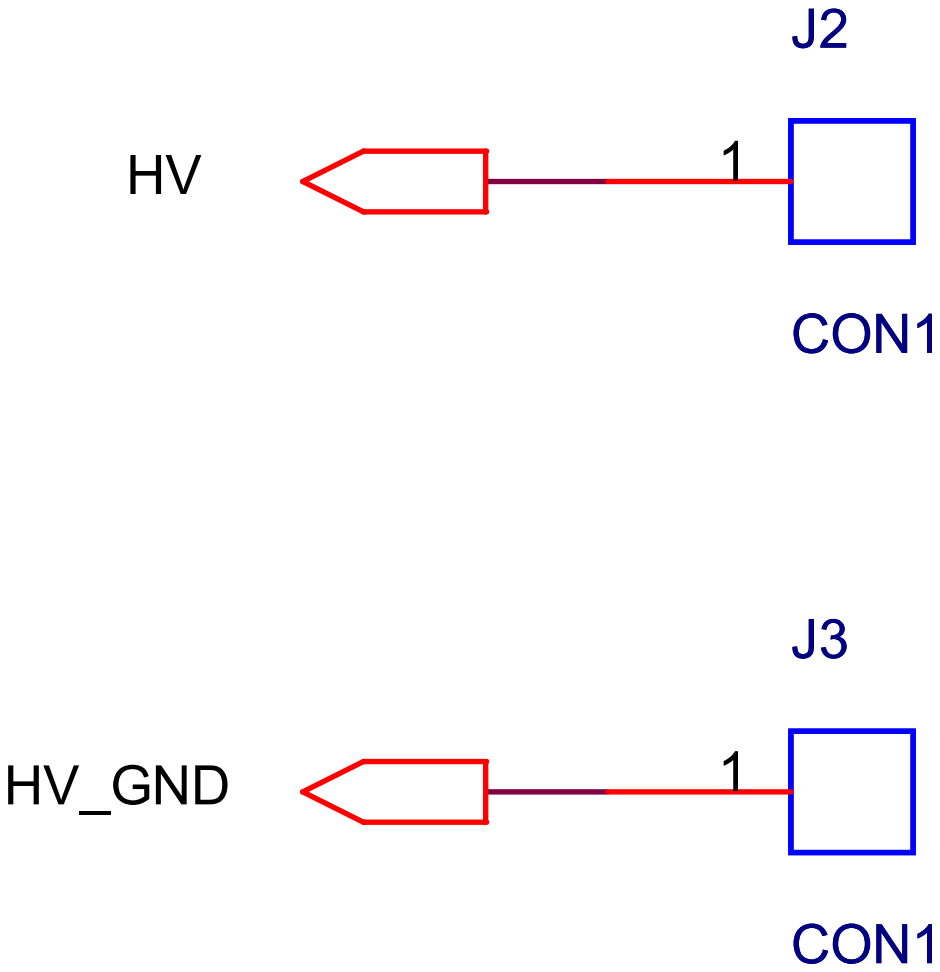
[picture p28: page 1]
HV_GND; Tam. Orden de Trabajo:; Rev.; Fecha:; Hoja; Patricio Coronado; Monday, December 11, 2017; CON1

SEGAIVEX
SEGAINVEX, Dpto. Electrónica
Diseñado:
Dibujado:
Título:
Fuente de alta tensión negativa
Archivo:
