SEGAINVEX-ELECTRONICA/Fuente-de-2KV-para-haz-de-electrones/(list of files, drawings)

Other design files:
Orcad/Fuente cañon+-2KV-30mA.opj
